mctomss/Proyecto_IDIE/Circuito Diseñado/flork.bmp

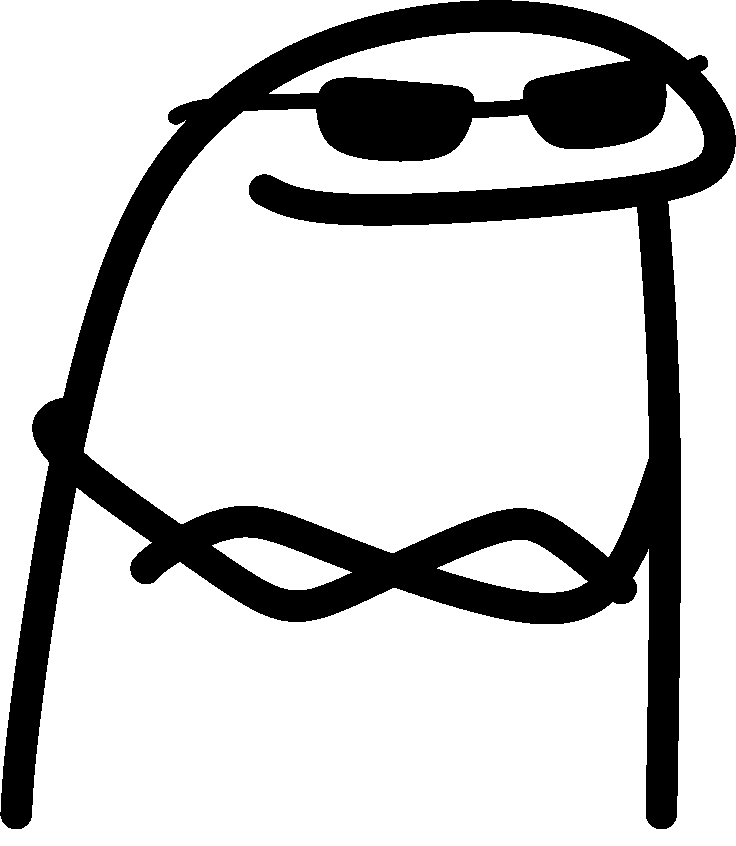
Circuito Diseñado/flork.bmp
