mctomss/Proyecto_IDIE/Footprints/LIB_ADE9153AACPZ/ADE9153AACPZ/3D/ADE9153AACPZ.stp

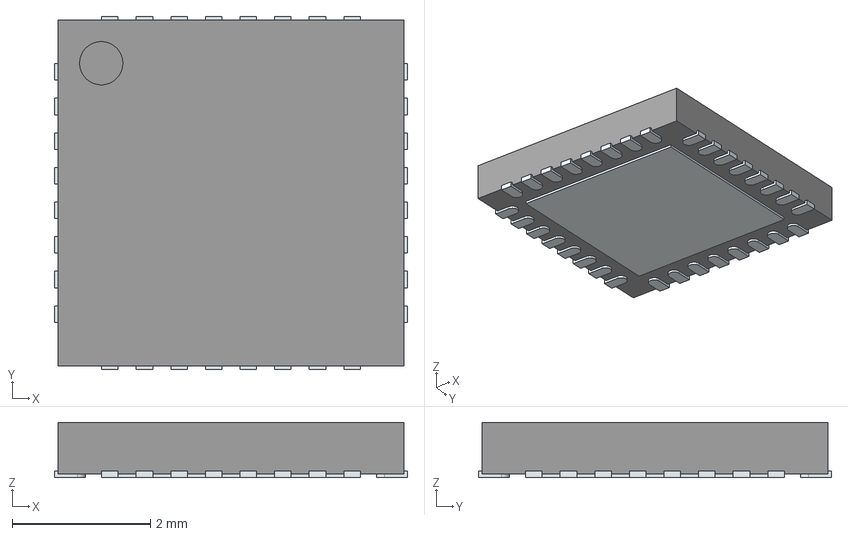
[picture p2: CAD file, 2024-11-09]
Footprints/LIB_ADE9153AACPZ/ADE9153AACPZ/3D/ADE9153AACPZ.stp
5.10 x 5.10 x 0.8 mm
ThermalPin
PinsArrayLR
PinsArrayTB
