mctomss/Proyecto_IDIE/Footprints/LIB_ESP32-S3-WROOM-1-N8/ESP32-S3-WROOM-1-N8/3D/ESP32-S3-WROOM-1-N8.stp

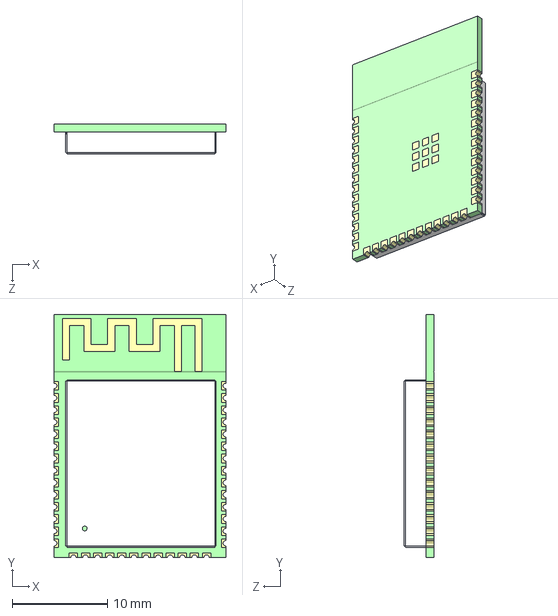
[picture p3: CAD file, 2024-11-09]
Footprints/LIB_ESP32-S3-WROOM-1-N8/ESP32-S3-WROOM-1-N8/3D/ESP32-S3-WROOM-1-N8.stp
18.0 x 25.5 x 3.10 mm
