mctomss/Proyecto_IDIE/Footprints/LIB_RAC03-3.3SK/RAC03-3.3SK/3D/RAC03-3.3SK.stp

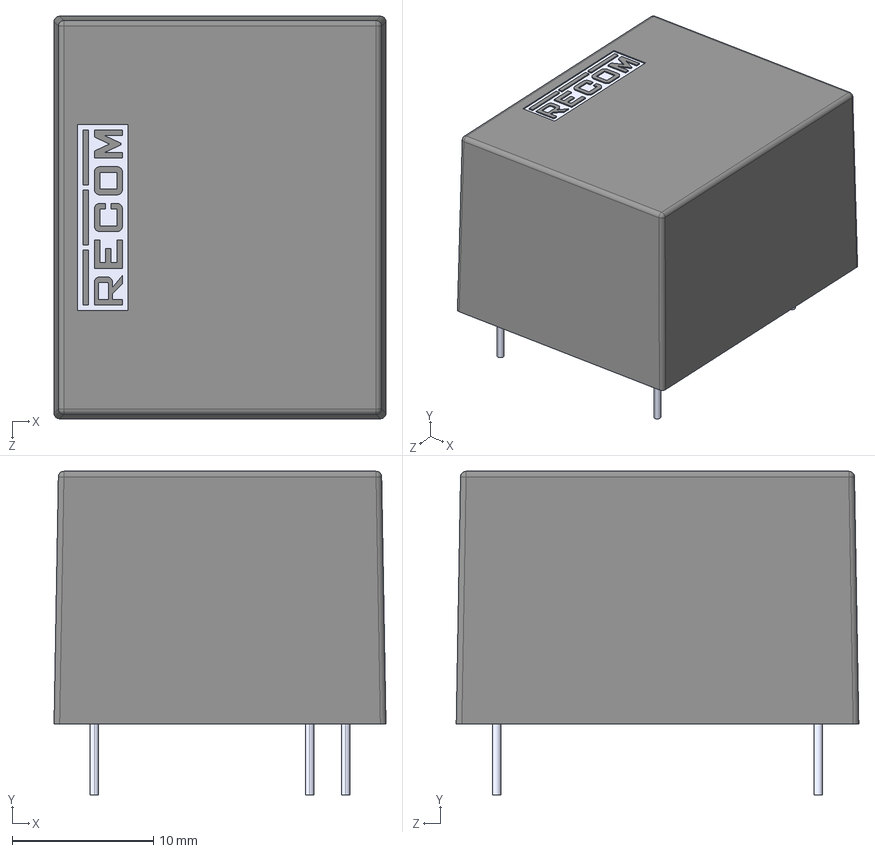
[picture p4: CAD file, 2024-11-09]
Footprints/LIB_RAC03-3.3SK/RAC03-3.3SK/3D/RAC03-3.3SK.stp
23.5 x 22.9 x 28.5 mm
RAC03-SK_pins.STEP
RAC03-SK_case.STEP
RAC03-SK_bottomplate.STEP
