mctomss/Proyecto_IDIE/(list of files, cad)

Other CAD files:
Footprints/LIB_ADE9153AACPZ/ADE9153AACPZ/Allegro/qfn50p500x500x80-33n-d.psm
Footprints/LIB_ADE9153AACPZ/ADE9153AACPZ/DEHDL/ade9153aacpz/chips/chips.prt
Footprints/LIB_ESP32-S3-WROOM-1-N8/ESP32-S3-WROOM-1-N8/DEHDL/esp32_s3_wroom_1_n8/chips/chips.prt
Footprints/LIB_RAC03-3.3SK/RAC03-3.3SK/Allegro/rac0305sk.psm
Footprints/LIB_RAC03-3.3SK/RAC03-3.3SK/DEHDL/rac03_3.3sk/chips/chips.prt
