mctomss/Proyecto_IDIE/(list of files, drawings)

Other design files:
Footprints/LIB_ADE9153AACPZ/ADE9153AACPZ/Altium/ADE9153AACPZ.SchLib
Footprints/LIB_ADE9153AACPZ/ADE9153AACPZ/Altium/QFN50P500X500X80-33N-D.PcbLib
