mctomss/Proyecto_IDIE/Circuito Diseñado/proyecto.brd

## EAGLE design Circuito Diseñado/proyecto.brd (2024-11-23)

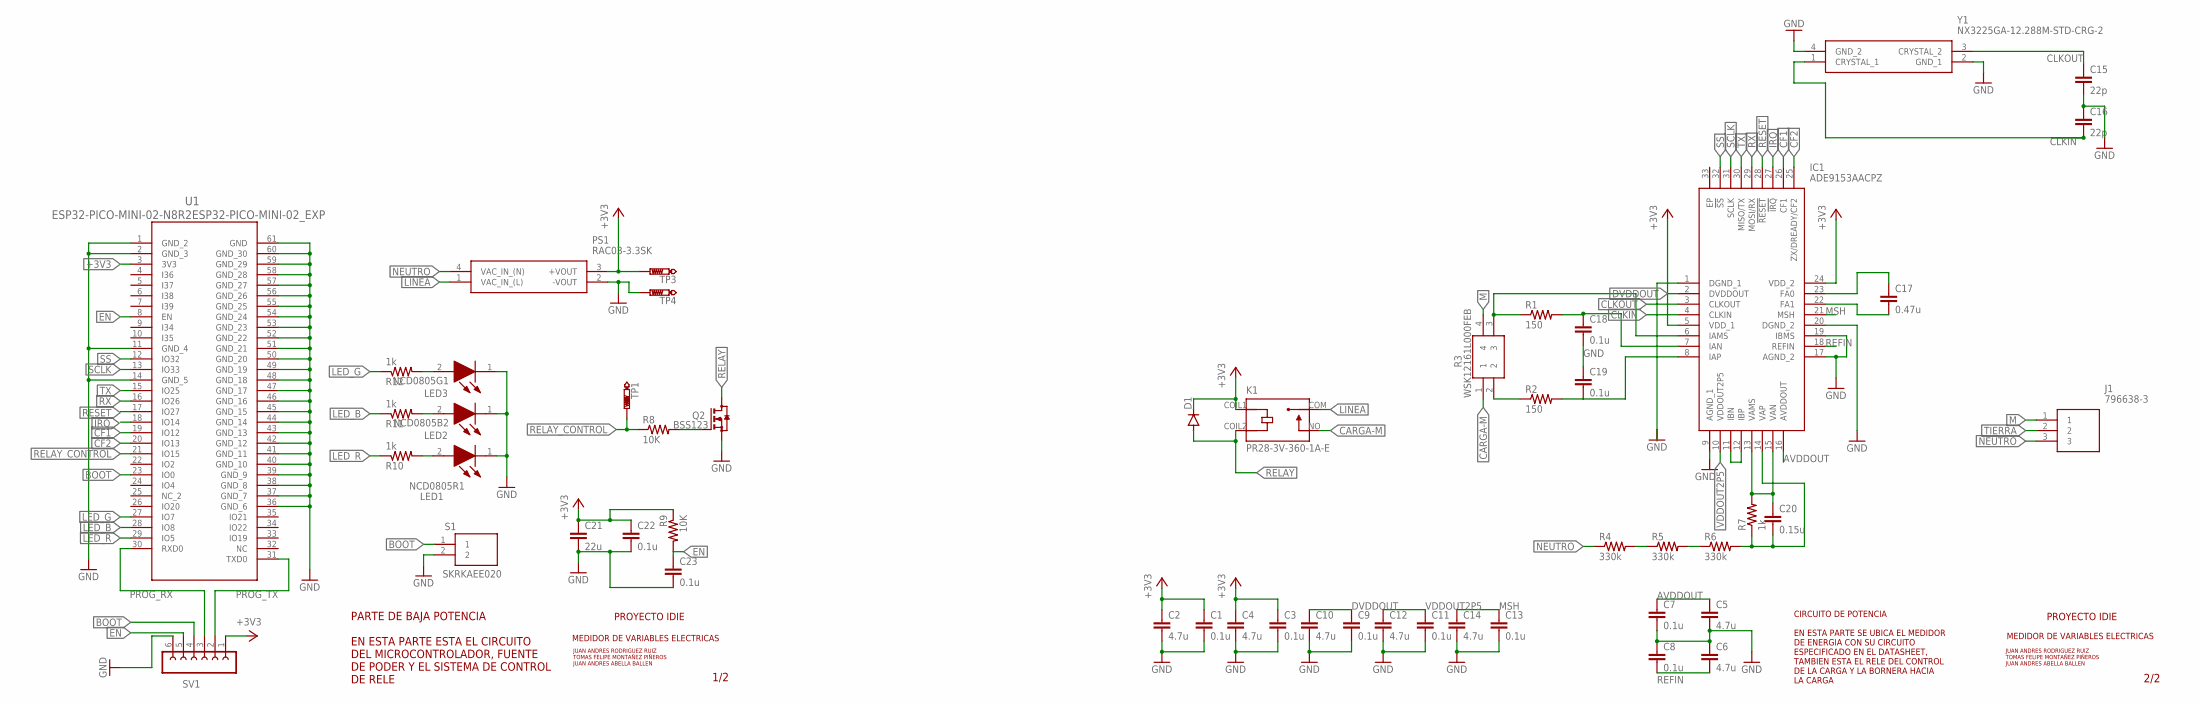
[picture p5: schematic proyecto.sch]

Parts:
C1, C3, C7, C8, C9, C11, C13, C18, C19, C22, C23: 0.1u; C0402K
C2, C4, C5, C6, C10, C12, C14: 4.7u; C0402K
C15, C16: 22p; C0402K
C17: 0.47u; C0402K
C20: 0.15u; C0402K
C21: 22u; C0402K
D1: DIODE-SMB; SMB
IC1: ADE9153AACPZ; QFN50P500X500X80-33N
J1: 796638-3; SHDRRA3W102P0X508_1X3_1706X120
K1: PR28-3V-360-1A-E; RELAY_PR28-3V-360-1A-E
LED1: NCD0805R1; LEDC2012X120N
LED2: NCD0805B2; LEDC2012X120N
LED3: NCD0805G1; LEDC2012X120N
PS1: RAC03-3.3SK; RAC0305SK
Q2: BSS123; SOT23
R1, R2: 150; R0402
R3: WSK12161L000FEB
R4, R5, R6: 330k; R0603
R7: 1k; R0603
R8, R9: 10K; R0402
R10, R11, R12: 1k; R0402
S1: SKRKAEE020
SV1: FE06-1; FE06
TP1, TP3, TP4: PTR1TP10R; TP10R
U1: ESP32-PICO-MINI-02-N8R2ESP32-PICO-MINI-02_EXP; ESP32-PICO-MINI-02_EXP
Y1: NX3225GA-12.288M-STD-CRG-2; NX3225GA12288MSTDCRG2

Connections:
+3V3: C1.1, C2.1, C3.1, C4.1, C21.1, C22.1, D1.C, IC1.5 (VDD_1), IC1.24 (VDD_2), K1.COIL1, PS1.3 (+VOUT), R9.1, SV1.1, TP3.TP, U1.3 (3V3)
AVDDOUT: C5.1, C7.1, IC1.16 (AVDDOUT)
BOOT: S1.1, SV1.4, U1.23 (IO0)
CARGA-M: K1.NO, R3.1
CF1: IC1.26 (CF1), U1.19 (IO12)
CF2: IC1.25 (ZX/DREADY/CF2), U1.20 (IO13)
CLKIN: C16.2, IC1.4 (CLKIN), Y1.1 (CRYSTAL_1)
CLKOUT: C15.1, IC1.3 (CLKOUT), Y1.3 (CRYSTAL_2)
DVDDOUT: C9.1, C10.1, IC1.2 (DVDDOUT)
EN: C23.1, R9.2, SV1.5, U1.8 (EN)
GND: C1.2, C2.2, C3.2, C4.2, C5.2, C6.1, C7.2, C8.1, C9.2, C10.2, C11.2, C12.2, C13.2, C14.2, C15.2, C16.1, C18.2, C19.1, C21.2, C22.2, C23.2, IC1.1 (DGND_1), IC1.9 (AGND_1), IC1.17 (AGND_2), IC1.19 (IBMS), IC1.20 (DGND_2), LED1.1 (K), LED2.1 (K), LED3.1 (K), PS1.2 (-VOUT), Q2.2 (S), S1.2, SV1.6, TP4.TP, U1.1 (GND_2), U1.2 (GND_3), U1.11 (GND_4), U1.14 (GND_5), U1.36 (GND_6), U1.37 (GND_7), U1.38 (GND_8), U1.39 (GND_9), U1.40 (GND_10), U1.41 (GND_11), U1.42 (GND_12), U1.43 (GND_13), U1.44 (GND_14), U1.45 (GND_15), U1.46 (GND_16), U1.47 (GND_17), U1.48 (GND_18), U1.49 (GND_19), U1.50 (GND_20), U1.51 (GND_21), U1.52 (GND_22), U1.53 (GND_23), U1.54 (GND_24), U1.55 (GND_25), U1.56 (GND_26), U1.57 (GND_27), U1.58 (GND_28), U1.59 (GND_29), U1.60 (GND_30), U1.61 (GND), Y1.2 (GND_1), Y1.4 (GND_2)
IRQ: IC1.27 (!IRQ), U1.18 (IO14)
LED_B: R11.1, U1.28 (IO8)
LED_G: R12.1, U1.27 (IO7)
LED_R: R10.1, U1.29 (IO5)
LINEA: K1.COM, PS1.1 (VAC_IN_(L))
M: J1.1, R3.4
MSH: C13.1, C14.1, IC1.21 (MSH)
unnamed: C17.1, IC1.23 (FA0)
unnamed: IC1.6 (IAMS), R1.1, R3.3
unnamed: C18.1, IC1.7 (IAN), R1.2
unnamed: C17.2, IC1.22 (FA1)
unnamed: C19.2, IC1.8 (IAP), R2.2
unnamed: R2.1, R3.2
unnamed: R4.2, R5.1
unnamed: R5.2, R6.1
unnamed: C20.2, IC1.14 (VAP), R6.2, R7.1
unnamed: C20.1, IC1.13 (VAMS), IC1.15 (VAN), R7.2
unnamed: LED1.2 (A), R10.2
unnamed: LED2.2 (A), R11.2
unnamed: Q2.1 (G), R8.2
unnamed: LED3.2 (A), R12.2
unnamed: IC1.11 (IBN), IC1.12 (IBP)
NEUTRO: J1.3, PS1.4 (VAC_IN_(N)), R4.1
PROG_RX: SV1.3, U1.30 (RXD0)
PROG_TX: SV1.2, U1.31 (TXD0)
REFIN: C6.2, C8.2, IC1.18 (REFIN)
RELAY: D1.A, K1.COIL2, Q2.3 (D)
RELAY_CONTROL: R8.1, TP1.TP, U1.21 (IO15)
RESET: IC1.28 (!RESET), U1.17 (IO27)
RX: IC1.29 (MOSI/RX), U1.16 (IO26)
SCLK: IC1.31 (SCLK), U1.13 (IO33)
SS: IC1.32 (!SS), U1.12 (IO32)
TIERRA: J1.2
TX: IC1.30 (MISO/TX), U1.15 (IO25)
VDDOUT2P5: C11.1, C12.1, IC1.10 (VDDOUT2P5)

Notes on the sheet:
PROYECTO IDIE
MEDIDOR DE VARIABLES ELECTRICAS
JUAN ANDRES RODRIGUEZ RUIZ
TOMAS FELIPE MONTAÑEZ PIÑEROS
JUAN ANDRES ABELLA BALLEN
1/2
PARTE DE BAJA POTENCIA EN ESTA PARTE ESTA EL CIRCUITO DEL MICROCONTROLADOR, FUENTE DE PODER Y EL SISTEMA DE CONTROL DE RELE
2/2
CIRCUITO DE POTENCIA EN ESTA PARTE SE UBICA EL MEDIDOR DE ENERGIA CON SU CIRCUITO ESPECIFICADO EN EL DATASHEET, TAMBIEN ESTA EL RELE DEL CONTROL DE LA CARGA Y LA BORNERA HACIA LA CARGA

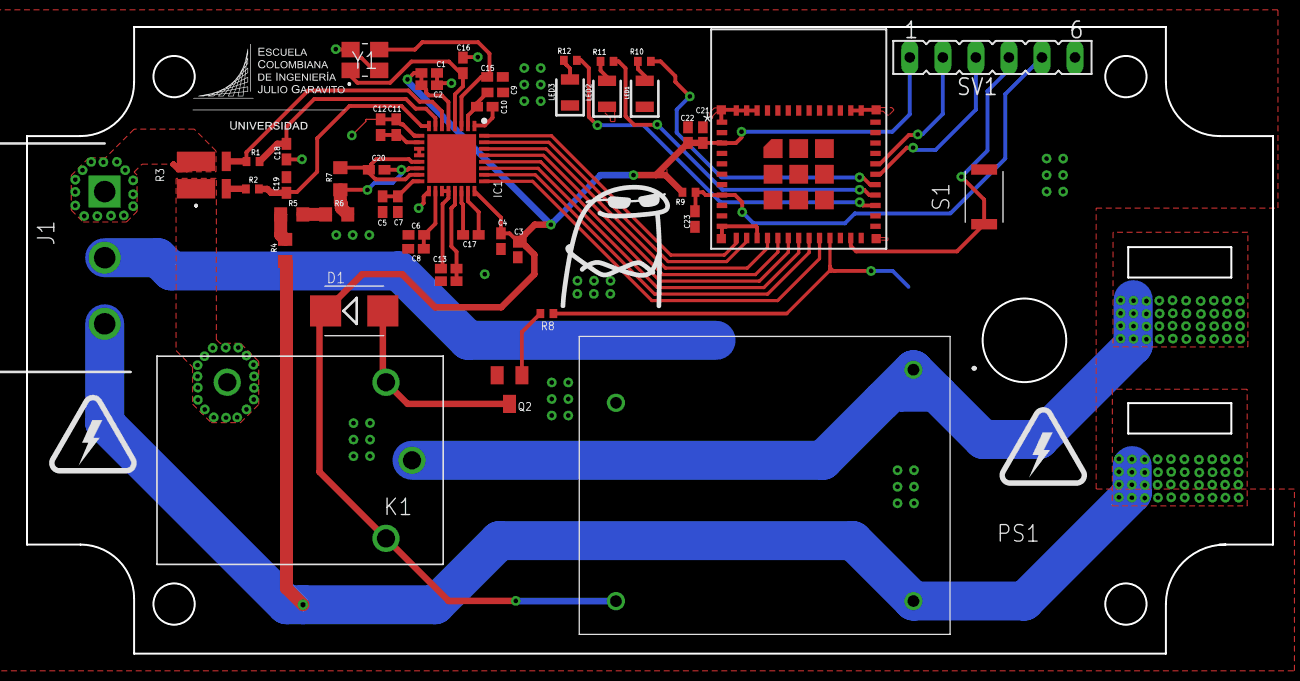
[picture p6: board proyecto.brd from above]

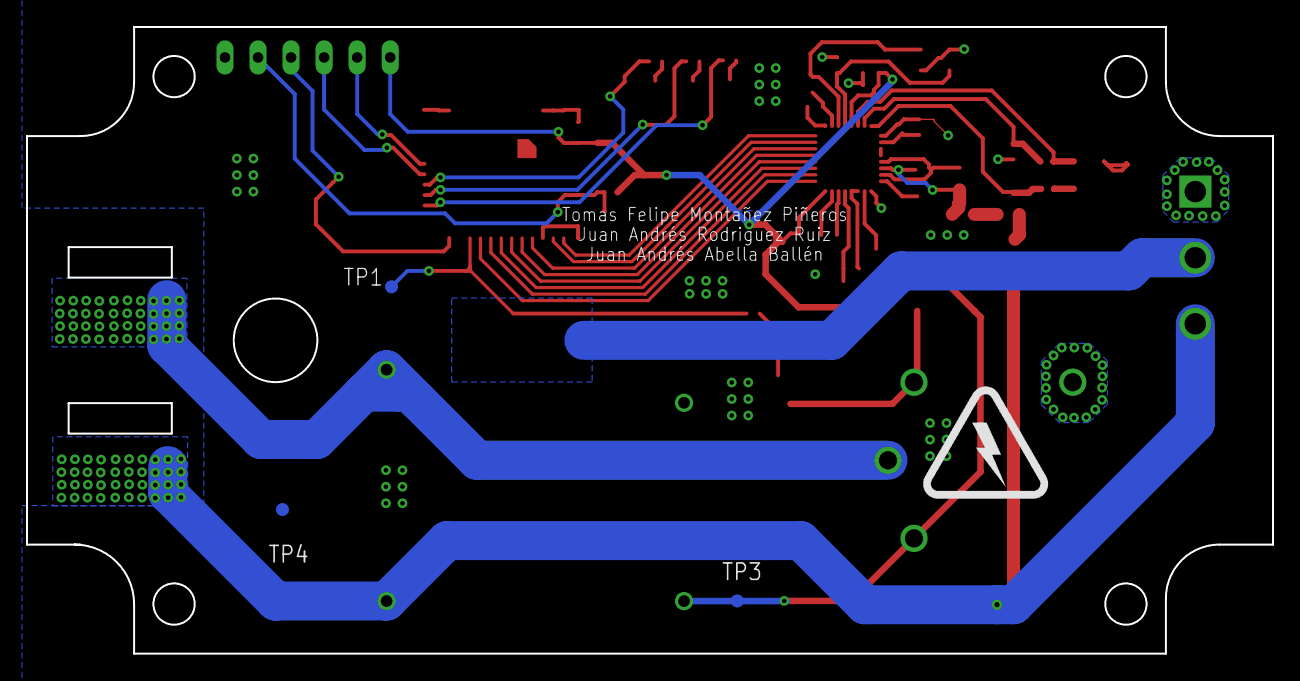
[picture p7: board proyecto.brd from below]

Board: 2 copper layers, 95.8 x 48.2 mm, 51 parts (3 on the bottom side), 45 nets.
