mctomss/Proyecto_IDIE/(commit log)

2024-09-03 Creacion de proyecto en Eagle
    La plantilla de PCB esta termindada
    [proyecto.brd, proyecto.sch]
2024-09-07 Avance :)
    .
    [proyecto.brd, proyecto.sch]
2024-09-14 Condensadores de acople del integrado de medicion de energia
    Se añadio algunos condensadores de acople que se especifico en la hoja de datos del medidor de energia y el oscilador que se especifica.
    [proyecto.brd, proyecto.sch]
2024-09-24 Conexiones según fabricante
    Se realizaron algunas conexiones de los condensadores de acople recomendados por el fabricante, se conecto tambien la resistencia Shunt y su filtro de antialising. Ademas se añadieron las resistencias para el sensado del voltaje.
    Por ultimo se añadio los condensadores de acople del ESP32
    [proyecto.sch]
2024-09-24 Actualizacion del gitignore
    Se coloco un gitignore para no subir los autoguardados
2024-09-28 Transistor de rele y headers para programar
    Se añadio el transistor mosfet que va a controlar el rele, ademas del header para la programacion de microcontrolador
    [proyecto.brd, proyecto.sch]
2024-10-05 Creacion de pistas y nuevos componentes
    Se hicieron las lineas criticas del circuito como lo son la fuente de alimentacion, linea, neutro, linea de medicion de corriente de la carga. Ademas se hicieron poligonos con el fin de conectar una capa con la otra.
    Ademas se añadio el circuito del Enable del microcontrolador
    [proyecto.brd, proyecto.sch]
2024-10-05 .
    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
    [proyecto.brd]
2024-10-19 MINI avance
    No se avanzó tanto debido a que se me daño las pistas en plena clase :(
    [proyecto.brd, proyecto.sch]
2024-10-25 Se añado y arreglo pistas
    Se arreglo las pistas de la fase y el neutro en las clavijas. Se añadieron otras pistas y se quito el boton del enable.
    [proyecto.brd, proyecto.sch]
2024-10-26 Terminada la mayoria de conexiones
    Se realizo la gran mayoria de las conexiones, falta realizar las conexiones especificadas en el DRC.
    [proyecto.brd, proyecto.sch]
2024-10-26 Errores DRC solucionados
    Se revisaron los errores DRC acerca de las conexiones faltantes. Ya no hay errores DRC. Falta montar diodos led indicativos y cambiar el boton de boot de ser necesario
    [proyecto.brd, proyecto.sch]
2024-10-27 Diseño terminado
    Se termino el diseño del esquematico y de la PCB
    [proyecto.brd, proyecto.sch]
2024-11-01 Se añadieron test pads
    [proyecto.brd, proyecto.sch]
2024-11-08 Adicion de pistas faltantes
    [proyecto.brd, proyecto.sch]
2024-11-09 Code FIles
    [ADE9153AACPZ.SchLib, ADE9153AACPZ.stp, EDI2CAP.CFG, ESP32-S3-WROOM-1-N8.stp, QFN50P500X500X80-33N-D.PcbLib, RAC03-3.3SK.stp, chips.prt, qfn50p500x500x80-33n-d.psm]
2024-11-10 Supongo que ya es el final
    :)
    [proyecto.brd]
2024-11-10 todo listo
    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
    [proyecto.brd]
2024-11-11 MQTT Error while connecting!
    [Firmware.ino]
2024-11-23 XDIN
    XDIN
    [proyecto.brd, proyecto.sch]
